daleward/HeaterMeter/(commit log)

2025-07-16 [3d] Add ESP32-C3-Zero sled for compatibility
    [MeterMonitor.scad]
2025-07-16 [3d] MeterMonitor mount clipping
    [MeterMonitor.scad]
2025-08-09 [3d] Include stand bit in MeterMonitor by default
    [MeterMonitor.scad]
